HiFiPhile/usb-sniffer_hw/(list of files, drawings)

Other design files:
CPLD.SchDoc
Host.SchDoc
Main.SchDoc
Port.SchDoc
Target.SchDoc
USB_Sniffer.PcbDoc
USB_Sniffer.PrjPcb
