HiFiPhile/usb-sniffer_hw/(threads)

Thread 1 (2023-08-29):

Placement of USB connectors

wocard2, 2023-08-29:
Please place the USB connectors in a way that makes it obvious (like the original PCB does) which connector is which without resorting to labels.

HiFiPhile, 2023-08-29:
In my working setup 2 connectors in the same side is easier for cable management and you don't need to read the label except the 1st time.

Closed 2023-08-29.
