HiFiPhile/usb-sniffer_hw/(commit log)

2023-08-15 Add files.
    [Host.SchDoc, Main.SchDoc, Port.SchDoc, Target.SchDoc, USB_Sniffer.PcbDoc, USB_Sniffer.PrjPcb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]
2023-08-25 Misc update.
    [Target.SchDoc, USB_Sniffer.PcbDoc, USB_Sniffer.PrjPcb]
2023-08-28 Add output files.
    [Host.SchDoc, Main.SchDoc, Port.SchDoc, Target.SchDoc, USB_Sniffer.PcbDoc, USB_Sniffer.PrjPcb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]
2023-08-28 Update EEPROM.
    [Host.SchDoc]
